dpw13/vestal-vamp/app/pinout.ods

Sheet: Func
 | SS | SCK | MISO | MOSI |  | CLK | CE | IO3 | IO2 | IO1 | IO0
SPI1 | pa4 | pa5 | pa6 | pa7 | OSPI | pa3 | pb6 | pa1 | pa3 | pb0 | pa2
 | pa15 | pb3 | pb4 | pb5 |  | pb2 | pb10 | pa6 | pa7 | pc10 | pb1
 | pg10 | pg11 | pg9 | pd7 |  | pf4 | pc11 | pc3 | pb13 | pd12 | pb12
 |  |  |  |  |  | pf10 | pe11 | pd13 | pc2 | pf1 | pc9
SPI2 |  |  | pb14 | pb15 |  |  | pg6 | pf3 | pe2 | pf9 | pd11
 | pb4 |  |  |  |  |  | pg12 | pf6 | pf2 |  | pf0
 |  | pb10 |  |  |  |  |  |  | pf7 |  | pf8
SPI3 | pa4 | pb3 | pb4 | pb2
 | pa15 | pc10 | pc11 | pb5
 |  |  |  | pc12
 |  |  |  | pd6 |  |  | SPI2 | pa11 | pa9 | pb14 | pb15
 |  |  |  |  |  |  |  | pb4 | pa12 | pc2 | pc1
SPI4 | pe4 | pe2 | pe5 | pe6 |  |  |  | pb9 | pb10 |  | pc3
 | pe11 | pe12 | pe13 | pe14 |  |  |  | pb12 | pb13
 |  |  |  |  |  |  |  |  | pd3
SPI5 | pf6 | pf7 | pf8 | pf9
 |  |  |  | pf11
SPI6 | pa0 | pa5 | pa6 | pa7
 | pa4 | pb3 | pb4 | pb5
 | pa15 | pc12 | pg12 | pg14
 | pg8 | pg13
 | RX | TX
usart10 | pe2 | pe3
usart10 | pg11 | pg12
lpuart1 | pa10 | pa9
usart1 | pa10 | pa9
lpuart1 | pb7 | pb6
usart1 | pb7 | pb6
usart1 | pb15 | pb14
usart2 | pa3 | pa2
usart2 | pd6 | pd5
usart3 | pb11 | pb10
usart3 | pc11 | pc10
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
