dpw13/vestal-vamp/io-exp/pinout.ods

Sheet: ATtiny816
 | Func | Pin | Analog | USART | SPI | TWI | CCL
0 | ~SS | PA4 | AIN4 |  | ~SS |  | LUT0-OUT
1 | EncA.Y | PA5 | AIN5
2 | PotA | PA6 | AIN6
3 | PotB | PA7 | AIN7 |  |  |  | LUT1-OUT
4 | PotC | PB5 | AIN8
5 | PotD | PB4 | AIN9 |  |  |  | LUT0-OUT
6 | RXD | PB3 |  | RXD
7 | TXD | PB2 |  | TXD
8 | PotE | PB1 | AIN10 |  |  | SDA
9 | PotF | PB0 | AIN11 |  |  | SCL
10 | TCB.WO (int LED) | PC0 |  |  | SCK
11 | TCD.WOD (ext LED) | PC1 |  |  | MISO |  | LUT1-OUT
12 | EncB.X | PC2 |  |  | MOSI
13 | EncB.Y | PC3 |  |  | ~SS |  | LUT1-IN
UPDI | EncA.X | PA0 | AIN0 |  |  |  | LUT0-IN
14 | MOSI | PA1 | AIN1 | TXD | MOSI | SDA | LUT0-IN
15 | MISO | PA2 | AIN2 | RXD | MISO | SCL | LUT0-IN
16 | SCK | PA3 | AIN3 |  | SCK
 | GND
 | 3.3V
 | Vdd

Sheet: Pot Bias
Vcc | 5
Rb | 1350
Rpot | 11000
Vref | 4.5
Vmax | 4.45344129554656
Range | 0.989653621232569
