dpw13/vestal-vamp/cad/top.pdf

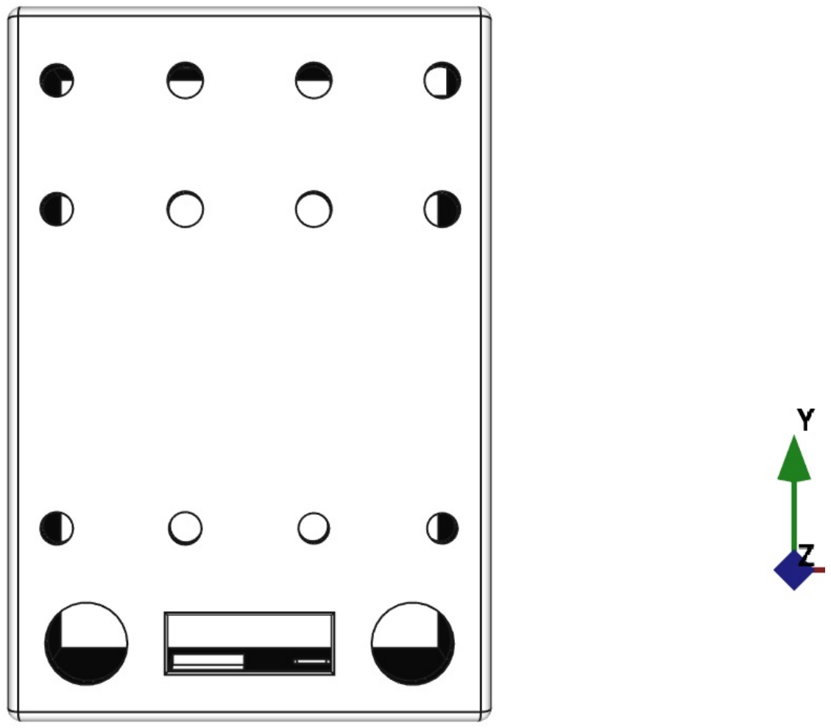
[picture p1: page 1]
