dpw13/vestal-vamp/cad/vestal-vamp.FCStd

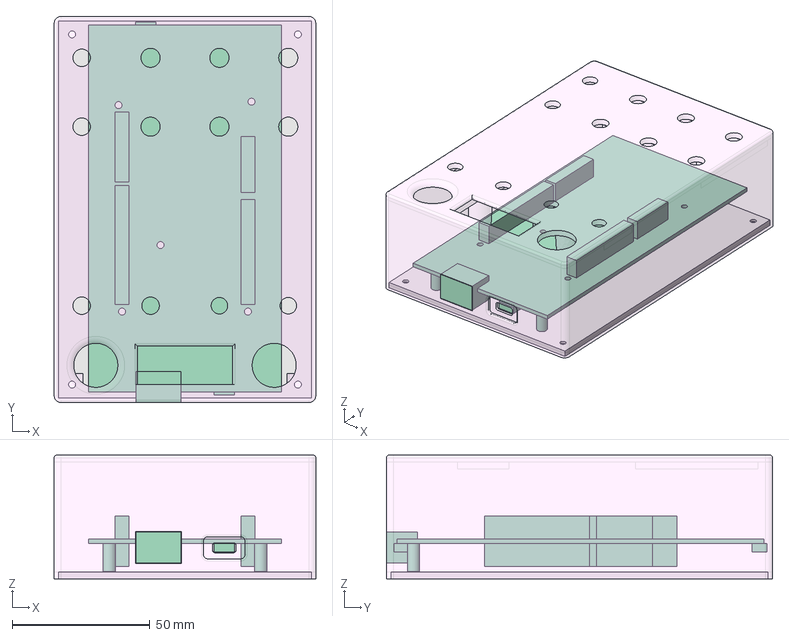
[picture p2: CAD file, 2024-11-10]
cad/vestal-vamp.FCStd
95.0 x 140.1 x 45.0 mm
Nucleo-144
Case
Bottom Lid
