dpw13/vestal-vamp/analog/input_lpf.asc

C1: cap; 1n
C2: cap; 2.2n
C3: cap; 1µ
R1: res; 1.6k
R2: res; 3k
R3: res; 1Meg
R4: res; 100k
R5: res; 100k
U1: UniversalOpAmp3; Avol=1Meg GBW=7.3Meg Slew=24Meg; Ilimit=500u Rail=0 Vos=0 Phimargin=45
V1: voltage; SINE(0 500m 440 100m 0 0 0); AC 1
V2: voltage; 2.5
Named nets: 0, Vcc, Vout
.ac dec 10 10m 1Meg
.tran 500m startup
