dpw13/vestal-vamp/app/src/ifft_dma.h

#ifndef __IFFT_DMA_H__
#define __IFFT_DMA_H__

#include <stdint.h>

void claim_dac_samples(void *buf, uint32_t len);
int ifft_init(void);

extern uint32_t ifft_mag_buf[10];

#endif /* __FFT_DMA_H__ */
