dpw13/vestal-vamp/(commit log)

2024-11-01 Initial import of CAD
    [vestal-vamp.FCStd]
2024-11-10 Update case
    [vestal-vamp.FCStd]
2024-11-10 Start io-expander
    [pinout.ods]
2024-11-10 Remove I2C, add SPI to ATtiny
2024-11-12 Remove USB and HTTP update mechanisms for now. Add USB DFU update on reset when holding down User button
    [main.c]
2024-11-14 First pass at audio ADC
2024-11-15 First pass at DAC DMA
2024-11-17 Add timer, link DAC to timer, try to time ADC unsuccessfully
2024-11-17 Finally got ADC synced!
2024-11-18 Small logging cleanup, use hardware SPI CS
2024-11-18 Add input FFT data flow
2024-11-19 Execute FFT in system work thread
2024-11-24 Add display reset and openocd debugging
    [display.c, main.c]
2024-11-27 Add io-expander SPI device. Move ADC and DAC channels out of the way.
2024-11-29 Rework ADC and DAC pinout, add DFSDM subsystem
    [adc.c, dac.c, dfsdm_stm32.c, dfsdm_stm32.h, fft_dma.c, filter.c, filter.h, main.c]
2024-11-30 First pass at FMAC driver
2024-11-30 Add FMAC driver, DFSDM fixes
    [dac.c, dfsdm_stm32.c, fft_dma.c, filter.c, fmac_stm32.c, main.c]
2024-12-02 Output oversampling and filtering fixes
    [audio.h, dac.c, dfsdm_stm32.c, dfsdm_stm32.h, filter.c, filter.h, fmac_stm32.c, fmac_stm32.h]
2024-12-02 Quite a lot of fixes, including caching issues
    [dfsdm_stm32.c, fft_dma.c, filter.c, ifft_dma.c, math_support.h]
2024-12-02 Fix injected tone phase
    [filter.c, ifft_dma.c]
2024-12-03 Add opamp, ADC and FFT fixes
    [dfsdm_stm32.c, fft_dma.c, filter.c, ifft_dma.c, main.c, math_support.h, opamp_stm32.c]
2024-12-04 Update DFSDM and FMAC configs to use enums, compile fixes
    [dfsdm_stm32.c, fmac_stm32.c, opamp_stm32.c, settings.h]
2024-12-04 Initial import of CORDIC DMA
2024-12-05 Initial import of CORDIC driver
2024-12-07 Fix CORDIC and FMAC error status
    [cordic_stm32.c, fmac_stm32.c]
2024-12-07 Use latest STLINK openocd driver
2024-12-09 Runtime analysis of time and freq domain samples, math fixes
    [dfsdm_stm32.c, dfsdm_stm32.h, fft_dma.c, filter.c, filter.h, ifft_dma.c, main.c, math_support.h]
2024-12-16 Add app pinout and filter simulations
    [pinout.ods]
2024-12-17 SPI to IO expander fixes
    [io.c, main.c, spi.c, uart.c]
